maiconrp/estacao-meteorologica/code/estacao/README.md

# `CODE` Sensores



## DHT22
O DHT22 é um sensor de umidade e temperatura digital que se comunica com o ESP32 através de um único pino de dados. Ele é composto por um termistor (para medir a temperatura) e um capacitor (para medir a umidade). Para utilizar o sensor, é necessário instalar a biblioteca DHT.h e criar um objeto "dht" inicializado com o pino de dados e o tipo de sensor (DHT22).

<br>
<br>
<br>
<br>
<hr>



## TEMT6000
O TEMT6000 é um sensor de luz ambiental que mede a luminosidade em uma faixa de 0 a 100.000 lux. Ele é compatível com vários microcontroladores, incluindo o ESP32. Para usar o TEMT6000, é necessário conectar o sensor ao ESP32 usando três fios (alimentação, GND e sinal) e usar uma biblioteca de software compatível.

<br>
<br>
<br>
<br>
<hr>



## BMP280
O BMP280 é um sensor de pressão atmosférica e temperatura que mede a pressão de 30 hPa a 110 hPa. Ele é compatível com vários microcontroladores, incluindo o ESP32. Para usar o BMP280, é necessário conectar o sensor ao ESP32 usando quatro fios (alimentação, GND, SDA e SCL) e usar uma biblioteca de software compatível.

<br>
<br>
<br>
<br>
<hr>



## Reed Switch
O Reed Switch é um sensor de contato que é usado para detectar se um objeto está presente ou ausente. Ele é composto por um ímã e um switch de contato que é ativado quando o ímã é aproximado. Ele é compatível com vários microcontroladores, incluindo o ESP32. Para usar o Reed Switch, é necessário conectar o sensor ao ESP32 usando dois fios (alimentação e sinal) e usar uma biblioteca de software compatível.

<br>
<br>
<br>
<br>
<hr>



## ESP32
O ESP32 é um microcontrolador de baixo custo e baixo consumo de energia que é baseado no chip ESP32 da Espressif. Ele é compatível com vários sensores, incluindo os mencionados acima, e pode ser programado usando uma variedade de linguagens de programação, incluindo C++ e Python. Ele possui WiFi, Bluetooth e capacidade de processamento integrados, tornando-o ideal para projetos IoT.
