maiconrp/estacao-meteorologica/docs/README.md

# `DOCS` Estação Meteorologica para Monitoramento de Irrigação por Gotejamento
