maiconrp/estacao-meteorologica/guia/README.md

# Guia de colaboração no projeto

Seja bem-vindo! Neste guia, você encontrará informações importantes sobre como trabalhar no projeto de maneira eficiente e colaborativa.

> 


> 


> 


> 


> 
