maiconrp/estacao-meteorologica/docs/Doc de visao/README.md

# `DOCS` Estação Meteorologica para Monitoramento
