maiconrp/estacao-meteorologica/guia/codigo.md

# Padrão de Código

:information_source: O **padrão de código** é a forma como o código é escrito e organizado em um projeto. Ele é importante para garantir que o código seja **fácil de ler, entender e manter**. Seguir um padrão de código ajuda a garantir que o código do projeto seja **consistente e de alta qualidade**.

<hr>

## Nomes de variáveis
✅ Os nomes de variáveis devem ser claros e descritivos. Eles devem ser escritos em minúsculas e, se precisarem de mais de uma palavra, devem ser separados por sublinhados.

Exemplo:

```
nome_da_variavel = valor
```
<hr>

## Nomes de funções
✅ Os nomes de funções devem ser escritos em minúsculas e, se precisarem de mais de uma palavra, devem ser separados por sublinhados. É importante que elessejam significativos e descritivos, de forma que o código fique fácil de ler e entender. Alguns exemplos de nomes de funções:

```
calcula_media()
converte_para_inteiro()
valida_cpf()
```
<hr>

## Nomes de classes
✅ Utilize nomes em CamelCase, começando com uma letra maiúscula. Por exemplo: "MyClass", "UserData", "CustomerService". Evite utilizar nomes de classes muito genéricos ou genéricos demais e não utilize abreviações ou siglas para nomes de classes. Alguns exemplos 

```
Usuario
RelatorioMensal
TesoureiroSede
```
<hr>

:bangbang: Os padrões de código fornecem um auxilio geral. Para nomear as classes, funções e variáveis, siga os diagramas sempre à risca. Você pode encontrá-los [aqui](https://github.com/maiconrp/AD-Gestao/tree/master/docs)
