maiconrp/estacao-meteorologica/guia/pull-request.md

# Pull Requests
:information_source: Um pull request é uma solicitação para adicionar as alterações de um branch a outro, geralmente um branch de desenvolvimento para o branch principal (por exemplo, o branch master). É uma forma de colaboração em projetos, pois permite que outras pessoas revisem e discutam as alterações antes que elas sejam integradas no projeto.

<hr>

## Como realizar um Pull Request
Para criar um pull request, basta seguir os seguintes passos:

* ✅ Crie uma branch para realizar as alterações no código.
* ✅ Realize as alterações no código e faça os **commits necessários**.
* ✅ Acesse o GitHub e navegue até a página do repositório.
* ✅ Vá para `Pull requests`
* ✅ Clique no botão *"New pull request"*.
* ✅ Selecione a **branch de origem** e a **branch de destino**.
* ✅ Insira uma descrição detalhada das alterações

<hr> 

## Importância de um bom pull request

Fornecer uma descrição detalhada das alterações realizadas no código é importante por várias razões:

* :information_source: **`Facilita a revisão do código`**: Quando outros membros da equipe têm uma descrição clara das alterações realizadas, eles podem verificar o código com mais facilidade e identificar possíveis problemas ou erros.

* :information_source: **`Ajuda a documentar o código`**: As descrições detalhadas das alterações servem como uma forma de documentação do código, o que pode ser útil no futuro caso alguém precise entender ou modificar o código.

* :information_source: **`Melhora a comunicação`**: Fornecer uma descrição detalhada das alterações ajuda a promover a comunicação eficaz entre os membros da equipe, garantindo que todos estejam alinhados e cientes das alterações realizadas no código.

<hr>

## Guia para Pull Requests
:information_source: Antes de fazer um pull request, é importante seguir alguns padrões para garantir que a integração do código seja suave e sem problemas. Aqui estão algumas dicas para criar um pull request de qualidade:

* :bulb: **`Siga os padrões de código`**: Certifique-se de que o código adicionado siga os padrões de código estabelecidos pelo projeto. Isso inclui coisas como identação, nomes de variáveis e funções, entre outras.

* :bulb: **`Teste o código`**: Certifique-se de que o código adicionado esteja funcionando corretamente antes de fazer o pull request. Execute testes unitários ou teste manualmente para garantir que o código esteja funcionando conforme o esperado.

* :bulb: **`Descreva as alterações`**: Forneça uma descrição detalhada das alterações realizadas no código. Isso ajudará os outros membros da equipe a entender o que foi modificado e por quê.

* :bulb: **`Crie um título claro`**: Escreva um título claro e conciso para o pull request. Isso ajudará os outros membros da equipe a entender de uma olhada rápida o que foi alterado.

* :bulb: **`Referência qualquer problema ou tarefa relacionada`**: Se o pull request estiver resolvendo um problema ou tarefa específica, inclua uma referência a ela no pull request

* :bulb: **`Preencha o template`**: Sempre preencha o template ao realizat sua pull requests, ele auxilia a equipe a entender quais alterações foram realizadas de maneira mais concisa e eficaz

<hr>

## Template de Pull Request

Um bom `Pull Request` deve fornecer informações suficientes para que os outros colaboradores possam **entender as alterações** realizadas e avaliar se elas são adequadas para serem integradas ao código principal. Para isso, este repositório conta com um **template de pull request**, ele é exibido como corpo da descrição ao realizar um pull request. 

Lembre-se de sempre preencher todos os itens da checklist antes de enviar o pull request, isso garantirá que as alterações sejam revisadas de maneira mais rápida e eficiente.
