maiconrp/estacao-meteorologica/docs/Diagramas/CasosDeUso.jpg

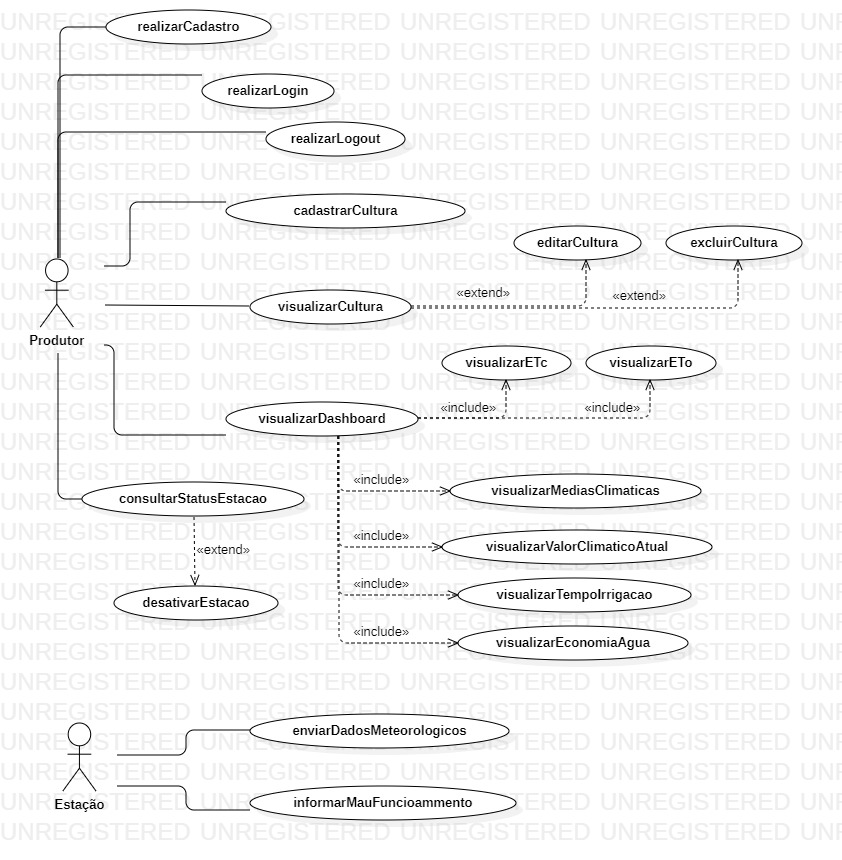
docs/Diagramas/CasosDeUso.jpg
