maiconrp/estacao-meteorologica/docs/Diagramas/ClassDiagram.jpg

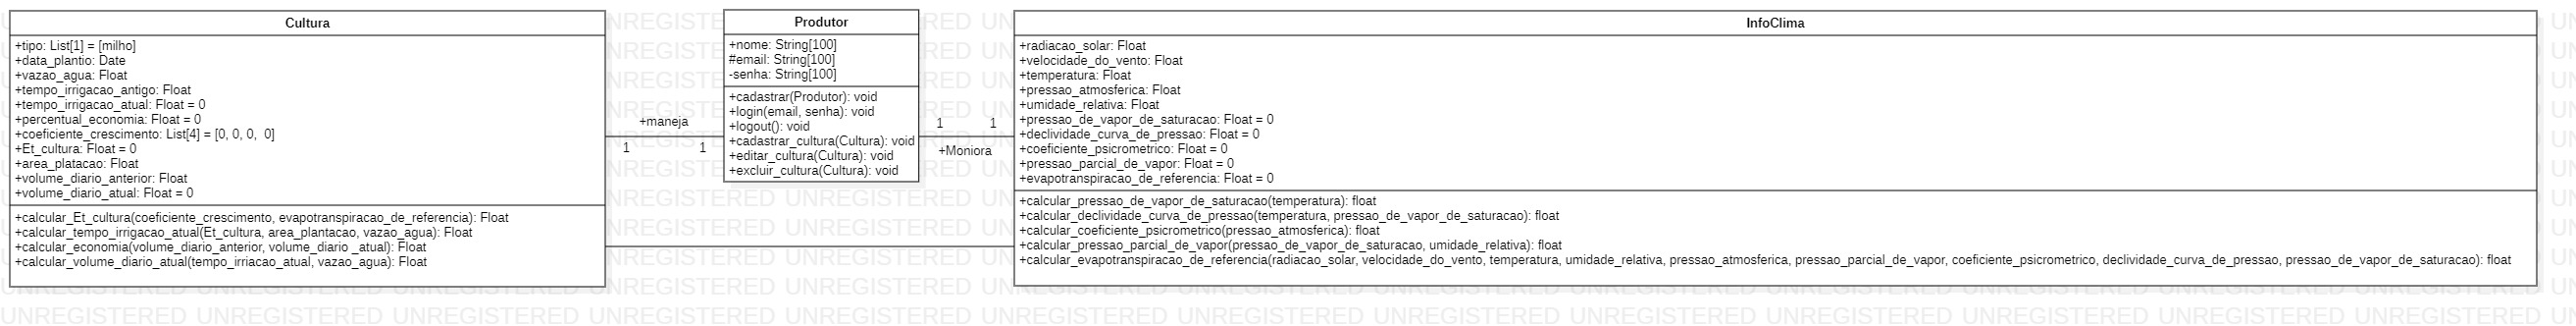
docs/Diagramas/ClassDiagram.jpg
