maiconrp/estacao-meteorologica/testes-estacao/Tables/Inmet/02-07-2023-INMET.csv

Data | Hora (UTC) | Temp. Ins. (C) | Temp. Max. (C) | Temp. Min. (C) | Umi. Ins. (%) | Umi. Max. (%) | Umi. Min. (%) | Pto Orvalho Ins. (C) | Pto Orvalho Max. (C) | Pto Orvalho Min. (C) | Pressao Ins. (hPa) | Pressao Max. (hPa) | Pressao Min. (hPa) | Vel. Vento (m/s) | Dir. Vento (m/s) | Raj. Vento (m/s) | Radiacao (KJ/m2) | Chuva (mm)
02/07/2023 | 300 | 21,7 | 21,8 | 21,1 | 49 | 49 | 45 | 10,5 | 10,5 | 8,9 | 954 | 954,4 | 954 | 6,1 | 95 | 10 | 0 | 0
02/07/2023 | 400 | 21,2 | 21,7 | 21,2 | 55 | 55 | 49 | 12 | 12 | 10,5 | 953,7 | 954 | 953,6 | 6,7 | 95 | 12 | 0 | 0
02/07/2023 | 500 | 20,9 | 21,3 | 20,9 | 56 | 56 | 55 | 11,8 | 12 | 11,7 | 953,2 | 953,7 | 953,2 | 5,4 | 95 | 10,6 | 0 | 0
02/07/2023 | 600 | 20,3 | 20,9 | 20,2 | 60 | 60 | 56 | 12,2 | 12,2 | 11,8 | 953,2 | 953,3 | 952,9 | 3,9 | 97 | 9,6 | 0 | 0
02/07/2023 | 700 | 20,1 | 20,3 | 19,7 | 63 | 63 | 60 | 12,8 | 12,8 | 12,2 | 953,3 | 953,3 | 953 | 2,8 | 125 | 6,5 | 0 | 0
02/07/2023 | 800 | 19,6 | 20,2 | 19,5 | 66 | 66 | 62 | 13 | 13 | 12,7 | 953,7 | 953,7 | 953,2 | 2,6 | 117 | 10,2 | 0 | 0
02/07/2023 | 900 | 19,4 | 19,7 | 19,2 | 67 | 67 | 66 | 13,1 | 13,1 | 12,8 | 954,2 | 954,3 | 953,6 | 1,9 | 133 | 6,1 | 0 | 0
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
