maiconrp/estacao-meteorologica/testes-estacao/Tables/Inmet/05-07-2023-INMET.csv

Data | Hora (UTC) | Temp. Ins. (C) | Temp. Max. (C) | Temp. Min. (C) | Umi. Ins. (%) | Umi. Max. (%) | Umi. Min. (%) | Pto Orvalho Ins. (C) | Pto Orvalho Max. (C) | Pto Orvalho Min. (C) | Pressao Ins. (hPa) | Pressao Max. (hPa) | Pressao Min. (hPa) | Vel. Vento (m/s) | Dir. Vento (m/s) | Raj. Vento (m/s) | Radiacao (KJ/m2)
05/07/2023 | 600 | 17,6 | 18,1 | 17,5 | 63 | 63 | 59 | 10,5 | 10,5 | 9,9 | 956,7 | 957,1 | 956,6 | 7,4 | 97 | 12,4 | 0
05/07/2023 | 700 | 16,5 | 17,6 | 16,5 | 68 | 68 | 63 | 10,6 | 10,7 | 10,5 | 957,1 | 957,1 | 956,7 | 3 | 122 | 12,1 | 0
05/07/2023 | 800 | 16,1 | 16,5 | 15,9 | 69 | 70 | 68 | 10,4 | 10,7 | 10,4 | 957,4 | 957,4 | 957,1 | 3,6 | 118 | 8,7 | 0
05/07/2023 | 900 | 16 | 16,3 | 15,8 | 69 | 69 | 68 | 10,4 | 10,5 | 10,2 | 957,9 | 957,9 | 957,4 | 3,4 | 119 | 8,7 | 0
05/07/2023 | 1000 | 17,1 | 17,1 | 16 | 64 | 69 | 64 | 10,2 | 10,5 | 10,2 | 958,4 | 958,4 | 957,9 | 4,6 | 121 | 7,4 | 267,6
05/07/2023 | 1100 | 18,9 | 19,1 | 17,1 | 56 | 64 | 56 | 10 | 10,4 | 10 | 959,1 | 959,1 | 958,4 | 5,4 | 100 | 10,6 | 1223,5
05/07/2023 | 1200 | 20,1 | 20,1 | 18,8 | 54 | 56 | 54 | 10,4 | 10,5 | 9,7 | 959,6 | 959,6 | 959,1 | 8,7 | 98 | 14,4 | 2302,4
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
