maiconrp/estacao-meteorologica/guia/issue.md

# Issues
:information_source: As issues são uma forma de gerenciar tarefas, problemas e ideias no projeto. Elas podem ser utilizadas para discutir problemas, documentar decisões, acompanhar o progresso do projeto e muito mais.

<hr>

## Como criar uma issue?

* ✅ Acesse o GitHub e navegue até a página do repositório.
* ✅ Vá para `Issues`
* ✅ Clique no botão `New issue`.
* ✅ Selecione o tipo, atualmente *"Bug"* ou *"Help"*, e clique em `Get Started`
* ✅ Preencha os campos de título e descrição da issue, com base no template
<hr>

## Padrões de nomenclatura para issues
É importante seguir alguns padrões de nomenclatura para manter o projeto organizado e facilitar a busca por issues específicas. Alguns padrões comuns incluem:

* ✅ Usar verbos no infinitivo no título da issue, como *"Adicionar recurso de busca"* ou *"Corrigir erro de login".*
* ✅ Adicionar um número de identificação à issue, como *"#123 Adicionar recurso de busca"*, mantendo-as ordenadas e facilitando a busca.
* ✅ Preencha os campos do template, facilitando a compreensão da **issue**
