maiconrp/estacao-meteorologica/(commit log)

2023-01-12 :books: docs: Add pasta para documentação
2023-01-12 :books: docs: Add pasta para codigo sensores
2023-01-12 :books: docs: Add pasta para codigo aplicação
2023-01-12 :books: docs: Corrigir erro de grafia no Titulo
2023-01-13 :books docs: Add ficheiros de documentação
2023-01-13 :books: docs: Add pasta Doc de visão
2023-01-16 :tada: add/teste: Led control com Firebase
2023-01-17 :wrench: refactor: Alter lib de conexão firebase
    Trocar `Firebase_ESP_Client.h` para `IXOhop_FirebaseESP32`
    Alterar chave de api (linha 13) para senha
    Remover criação de user anonimo para conectar diretamente com a chave
    Trocar versão da lib arduinoJson para 5.13.3
2023-01-17 :wrench: code/teste: Remover duplicação de pastas
2023-01-19 :books: docs: Atualizar diaggrama de classes
2023-01-20 :books: docs: Add JPEG diagrama de classes
2023-01-20 :books: docs: Att diagrama de classes
2023-01-20 :books: docs: Add documento de visão
2023-01-20 :books: code: Add código de este para o sensor Temt6000
2023-01-21 :books: docs: Add relatório de testes
2023-01-22 :books: docs: Add relatorio teste led
2023-01-22 :books: docs: Corrigir titulo de "led" para "DHT"
2023-01-22 :books: docs: Descrever sensores
2023-01-22 :books: docs: Possivel estrutura de código
2023-01-24 :books: code: Att doc de visão
2023-01-24 :books: code: Add diagrama de casos de uso
2023-01-24 :tada: code/teste: Estrutura de Codigo App
2023-01-25 :wrench: code: add arquivo de configurações
2023-01-25 :wrench: code: add arquivo de config globais
2023-01-25 :recycle: refactor: Corrigir importação de config
2023-01-26 :wrench: config: Alterar config.txt para json
2023-01-26 :wrench: segurança: Criar json de configurações
2023-01-28 :bulb: comments: Add comentários de código
2023-01-28 :recycle: refactor: Trocar forma de importação
2023-01-30 :tada: test/code: Teste de componente `UserControl`
2023-02-07 :tada: code: Add teste de coleta
2023-02-28 :tada: code/testes/teste_app/pages/home.py: Add novos controls para buildar
2023-03-02 :wrench: chore: Add setup de instalação
2023-03-02 :tada: code/testes/testes_app/assets: Add folder de assets
2023-03-03 :construction: code: Tentar adicionar icone de assets no botão
2023-03-07 :truck: move login para pasta auth
2023-03-07 :tada: :test: add appbar e navbar para teste
2023-03-08 :tada: update: Herdar classe de UserControl
2023-03-08 :tada: upgrade: Criar classe para destinos
2023-03-08 :truck: build: Mover teste para apps
2023-03-09 :lipstick: feat: Step para check py versao
2023-03-10 :construction: feat: Add componentes de clima
2023-03-10 :construction: feat: Add Alert dialog de info cultura
2023-03-10 :construction: feat: Add components de clima na page
2023-03-10 :sparkles: feat: Add icons de seta
2023-03-11 :truck: file: mover arquivos para pastas
2023-03-11 :recycle: refactor: melhorar modo de configurar pag
2023-03-11 :construction: progress: ajustar ordem de layout
2023-03-14 :sparkles: feat: Add AlertDialog de status da estação
2023-03-14 :sparkles: feat: Add AlertDialog de detalhes da cultura
2023-03-14 :sparkles: feat: Add AlertDialog de cadastro de cultura
2023-03-14 :tada: feat: Add BotomSheet de Perfil
2023-03-15 :Wrench: feat: Adjust height of estação button
2023-04-11 :tada: feat: Set correct sensor to get temp
2023-06-21 :test_tube: feat: Add aplicativo de validação do projeto
    [01-06-2023-INMET.csv, 02-06-2023.csv, 05-06-2023-INMET.csv, 20-05-2023.csv, 31-05-2023.csv]
2023-07-13 Versão para feira
2023-07-18 :tada: feat: Last Versão
    [01-06-2023-INMET.csv, 02-06-2023.csv, 05-06-2023-INMET.csv, 20-05-2023.csv, 31-05-2023.csv]
2024-11-16 :sparkles: Add dados de etapa de testes da estação
    [01-07-2023-INMET.csv, 02-07-2023-INMET.csv, 05-07-2023-INMET.csv, 30-06-2023-INMET.csv]
